ufan/paw3395_pmw3361_breakout/pmw3395_3361.kicad_pcb

## KiCad design pmw3395_3361.kicad_pcb (2022-09-10)

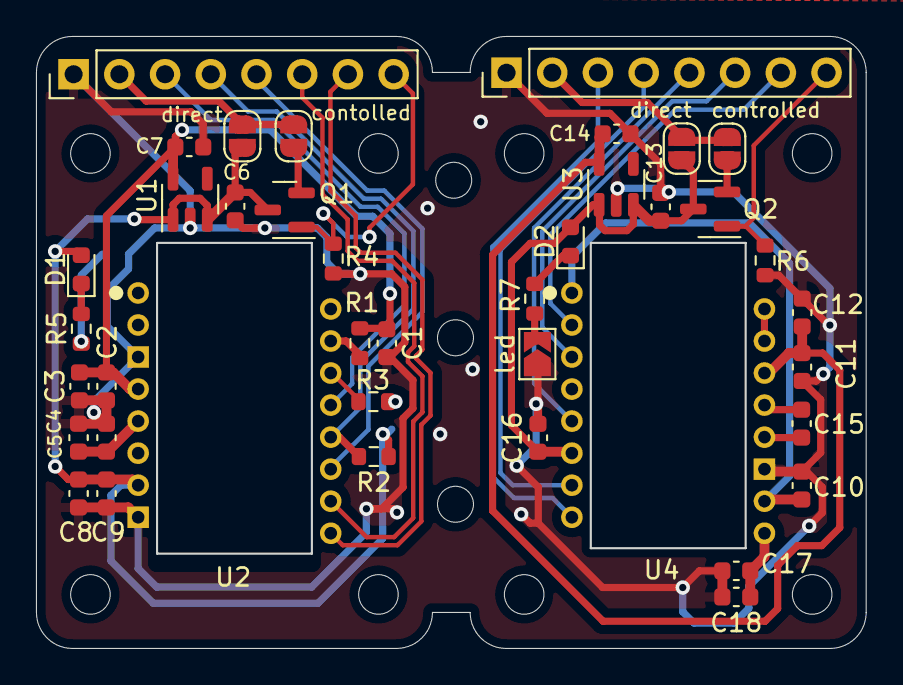
[picture p1: board pmw3395_3361.kicad_pcb from above]

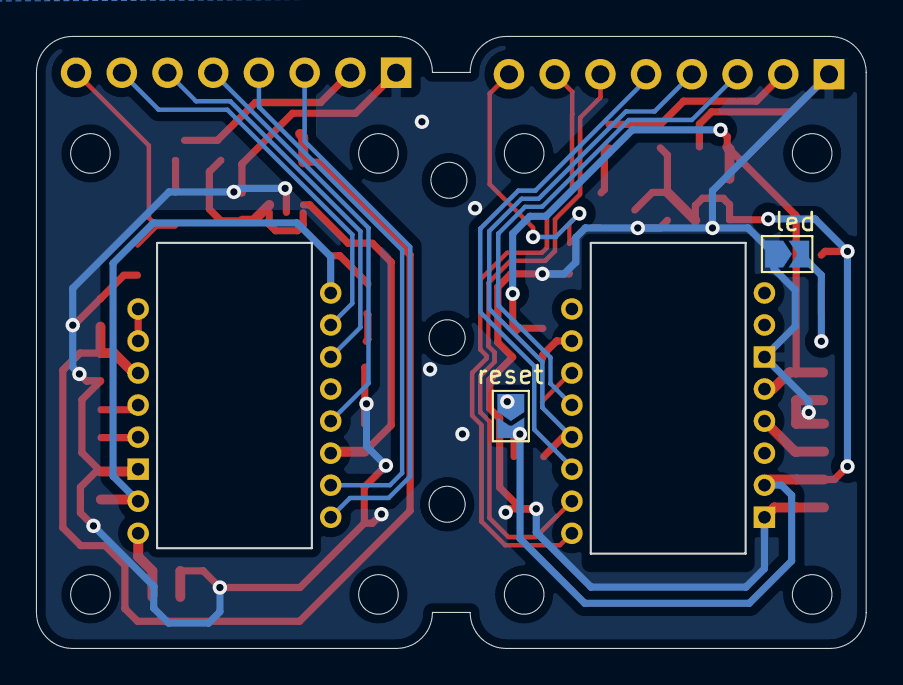
[picture p2: board pmw3395_3361.kicad_pcb from below]

Board: 2 copper layers, 46.1 x 34.0 mm, 42 parts (2 on the bottom side), 34 nets.

Parts:
C1: 33u; C_0603_1608Metric
C2, C4, C6, C8, C13: 0.1u; C_0603_1608Metric
C3, C9: 10u; C_0603_1608Metric
C5: 4.7u; C_0603_1608Metric
C7, C14: 1u; C_0603_1608Metric
C10: 10n; C_0603_1608Metric
C11, C16: 100n; C_0603_1608Metric
C12: 3.3u/16V; C_0603_1608Metric
C15: 100n (X7R); C_0603_1608Metric
C17: 10u (X7R); C_0603_1608Metric
C18: 10n (X7R); C_0603_1608Metric
D1, D2: Orange; LED_0603_1608Metric
J1, J2: Conn_01x08; PinHeader_1x08_P2.54mm_Vertical
Q1, Q2: AO3401A; SOT-23
R1: 5.6; R_0603_1608Metric
R2: 10k; R_0603_1608Metric
R3, R4, R6: 2M; R_0603_1608Metric
R5, R7: 100; R_0603_1608Metric
U1, U3: TCR2EF19; SOT-23-5
U2: PAW3395
U4: PMW3610
contolled: SolderJumper_2_Open; SolderJumper-2_P1.3mm_Open_RoundedPad1.0x1.5mm
controlled: SolderJumper_2_Open; SolderJumper-2_P1.3mm_Open_RoundedPad1.0x1.5mm
direct: SolderJumper_2_Open; SolderJumper-2_P1.3mm_Open_RoundedPad1.0x1.5mm
direct#2: SolderJumper_2_Open; SolderJumper-2_P1.3mm_Open_RoundedPad1.0x1.5mm
led: SolderJumper_2_Open; SolderJumper-2_P1.3mm_Open_TrianglePad1.0x1.5mm
led#2: SolderJumper_2_Open; SolderJumper-2_P1.3mm_Open_TrianglePad1.0x1.5mm
reset: SolderJumper_2_Open; SolderJumper-2_P1.3mm_Open_TrianglePad1.0x1.5mm

Connections:
+1V8: C1.1, C2.1, C3.1, C7.1, R1.1, U1.5 (OUT), U2.4 (VDD)
+1V9: C11.1, C12.1, C14.1, U3.5 (OUT), U4.14 (VDD)
+3.3VA: C6.2, C8.1, C9.1, D1.2 (A), Q1.3 (D), R2.1, U1.1 (IN), U1.3 (EN), U2.7 (VDDIO), direct.2 (B), reset.2 (B)
+3V3: J1.2, contolled.1 (A), direct.1 (A)
+3V3_CUT: J1.8, Q1.1 (G), R4.2
GND: C1.2, C2.2, C3.2, C4.2, C5.2, C6.1, C7.2, C8.2, C9.2, C10.2, C11.2, C12.2, C13.1, C14.2, C16.2, C17.2, C18.2, J1.1, J2.1, R4.1, R6.1, U1.2 (GND), U2.3 (GND), U2.8 (GNDIO), U3.2 (GND), U4.11 (GND), led.1 (A), led#2.1 (A)
MISO: J1.4, R2.2, U2.12 (MISO)
MOSI: J1.5, U2.11 (MOSI)
MOTION: J1.7, U2.9 (MOTION)
MOTION_2: J2.3, U4.8 (MOTION)
NCS: J1.3, U2.13 (NCS)
NCS_2: J2.5, U4.5 (NCS)
unnamed: C4.1, C5.1, U2.5 (VDDREG)
unnamed: C10.1, U4.1 (+VCSEL), U4.10 (PASS_T)
unnamed: C15.1, U4.13 (CN)
unnamed: C15.2, U4.12 (CP)
unnamed: C17.1, C18.1, U4.9 (VCP)
unnamed: D1.1 (K), R5.1
unnamed: D2.1 (K), R7.1
unnamed: R3.1, reset.1 (A)
unnamed: R5.2, led#2.2 (B)
unnamed: Q1.2 (S), contolled.2 (B)
unnamed: R7.2, led.2 (B)
unnamed: Q2.2 (S), controlled.2 (B)
unnamed: R1.2, U2.15 (LED_P)
unnamed: R3.2, U2.14 (NRESET)
unnamed: U4.15 (XYLASER), U4.16 (-VCSEL)
RESET_2: J2.4, U4.7 (NRESET)
SCLK: J1.6, U2.10 (SCLK)
SCLK_2: J2.6, U4.3 (SCLK)
SDIO_2: J2.7, U4.2 (SDIO)
VCC: J2.2, controlled.1 (A), direct#2.1 (A)
VCC_CUT: J2.8, Q2.1 (G), R6.2
VCC_OUT: C13.2, C16.1, D2.2 (A), Q2.3 (D), U3.1 (IN), U3.3 (EN), U4.6 (VDDIO), direct#2.2 (B)
