ufan/paw3395_pmw3361_breakout/(commit log)

2022-08-20 [v0.99] initial verion with two connected breakout boards
    for paw3395 and pmw3361 respectively
    [pmw3395_3361.kicad_pcb, pmw3395_3361.kicad_sch]
2022-08-31 bugfix
    enlarge pmw3395 edge cut, the dimension given in the datasheet is
    smaller than actual size. The same for pmw3360
    [pmw3395_3361.kicad_pcb]
2022-09-10 update the real optical centor in user.drawings
    [pmw3395_3361.kicad_pcb]
